sethshill/tsalivd/(commit log)

2012-01-12 Release candidate
    [tsalivd.brd, tsalivd.sch]
2012-01-12 Ajout de la documentation
